samm-git/clock-controller-esp/(threads)

Thread 6 (2020-09-27):

OLED screen is degrading in a short term if not powered off

samm-git, 2020-09-27:
## Issue

Few users reported that constantly on OLED would degrade in a 6-12m. Easiest workaround would be to turn it off after n minutes of activity (e.g. 5) and turn it on only on keypress or in case of event (e.g. wifi lost). Additionally it would be nice to render few random pixels to show that device is still powered.

## Acceptance criteria

- [ ] Time added and reacting to GPIO connected button
- [ ] Button added to the case and connected to the ESP.
- [ ] updateScreen respecting it and showing screensaver instead of the normal view

Closed 2020-09-27.

Thread 8 (2024-02-20):

preferences - max. write cycles

DIYLAB-DE, 2024-02-20:
I'm a bit worried that the values saved every minute with "Preferences" could damage the ESP32.
Isn't the maximum write cycle approx. 100000x ?

samm-git, 2024-04-07:
Technically I think we will never reach it. Data is stored on [NVS partition](https://docs.espressif.com/projects/esp-idf/en/latest/esp32/api-reference/storage/nvs_flash.html) which I did big enough, so I hope that it is evenly distributed across it. As you can see - this repo is 4 years old and the clock is still working perfectly, including TZ changes, etc. IMO there is a chance that board will be obsoleted much faster compared to flash wear out, so I don't want to fix what is not broken.

The likely best option would be to add cheap i2c RTC to the device, so time would tick when the device is out of main power, and these RTCs usually have some battery-powered bytes that could be used to store physical clock status. But I am lazy enough to fix what is not broken :)

Closed 2024-04-07.
