samm-git/clock-controller-esp/images.h

const uint8_t  polarity_a[] = {
  0x0F, 0x0F, 0x0F, 0x0F, 0x08, 0x01, 0x08, 0x01, 0x08, 0x01, 0x08, 0x01,
  0xF8, 0x01, 0xF8, 0x01, 
};

const uint8_t  polarity_b[] =  {
  0xF8, 0x01, 0xF8, 0x01, 0x08, 0x01, 0x08, 0x01, 0x08, 0x01, 0x08, 0x01,
  0x0F, 0x0F, 0x0F, 0x0F, 
};
