samm-git/clock-controller-esp/(commit log)

2020-09-21 Fix very stupid bug with one lost minute
    [clock-controller.ino]
2020-09-21 Fix name stage name
2020-09-21 Allow up to 5m drift without full circle (#4)
    [clock-controller.ino]
2020-09-24 Use log_i instead of serial to print info messages
2020-09-24 Set correct hostname during DHCP request
    [clock-controller.ino]
2026-09-07 Improve wifi reconnection reliability and networking (#11)
    * - Improve wifi reconnection reliability (event handler, auto-reconnect, disable modem sleep)
    - Add boot timeouts for wifi and NTP so the device never hangs without network
    - Only move the slave clock once a valid time is available
    - Check DNS lookup result before sending NTP packet
    - Replace per-second String allocations with snprintf buffers
    - Fix misleading comment about clock being ahead/behind NTP
    - do not call updateScreen if there is nothing to update
    * Upgrade actions
    * Start vertical line not from the top to get more space for the wifi name
    * Update readme
    [clock-controller.ino]
